CCLexow/Getting_started_with_ROS/README.md

# Getting_started_with_ROS
Repository containing project(s) to learn programming with ROS
