CCLexow/Getting_started_with_ROS/Sharp_DistanceSensor/README.md

Design files (HW/SW/MECH) for a motorized distance sensor to perform 360° scans.

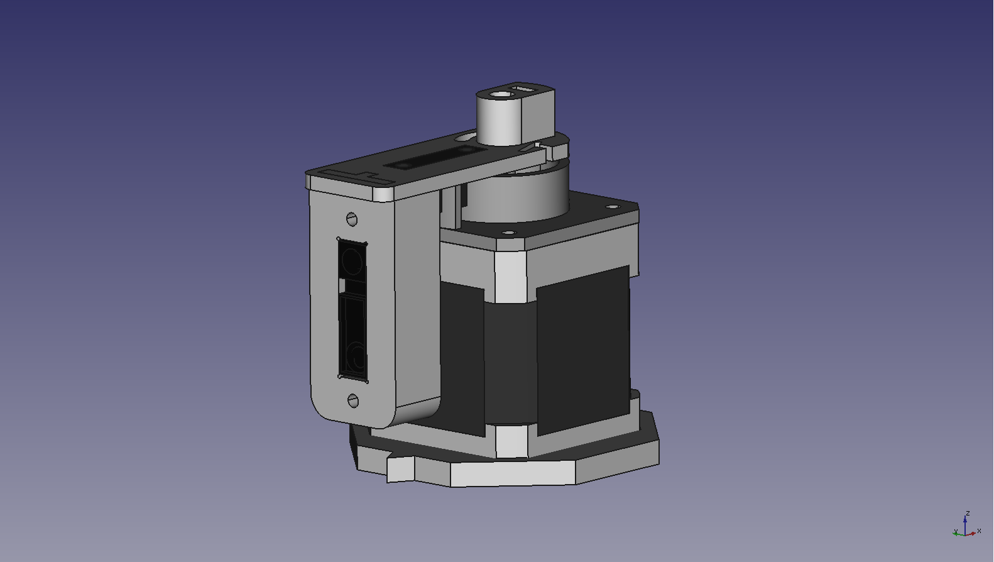
[picture p1: Sharp_DistanceSensor/MCAD/Images/SharpDistanceSensorAssembly.png]


Designed using:
* [FreeCAD](https://www.freecadweb.org)
* [KiCad EDA](http://kicad-pcb.org)
* [System Workbench for STM32](http://www.openstm32.org/HomePage)
