CCLexow/Getting_started_with_ROS/Sharp_DistanceSensor/MCAD/README.md

# MCAD Files



Designed with [FreeCAD](https://www.freecadweb.org)
# Credits
External 3D models:
* [TMC2100 SilentStepStick PCB](https://grabcad.com/library/tmc21x0-silentstepstick-board-1)
* [STM32 "BluePill" module](https://grabcad.com/library/stm32f103c8t6-blue-pill-board-1)
* [Sharp Distance Sensor](https://grabcad.com/library/sharp-gp2y0a21yk0f)
* [NEMA 17 Stepper model](https://github.com/FreeCAD/FreeCAD-library/blob/master/Electrical%20Parts/Motors/NEMA-17_Stepper_Motor_47mm.step)
