CCLexow/Getting_started_with_ROS/Sharp_DistanceSensor/ECAD/README.md

# ECAD Files

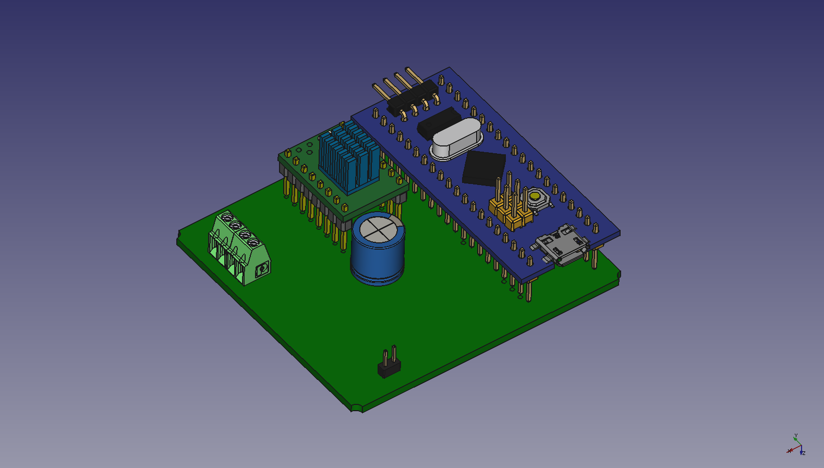
[picture p2: Sharp_DistanceSensor/MCAD/Images/MCU_StepperDriverPCB_Top.png]


Designed with [KiCad EDA](http://kicad-pcb.org)
# Credits
External 3D models:
* [TMC2100 SilentStepStick PCB](https://grabcad.com/library/tmc21x0-silentstepstick-board-1)
* [STM32 "BluePill" module](https://grabcad.com/library/stm32f103c8t6-blue-pill-board-1)
