CCLexow/Getting_started_with_ROS/Sharp_DistanceSensor/ECAD/MCU_StepperDriverPCB/Images/MCU_STMD_PCB_Milled.jpg

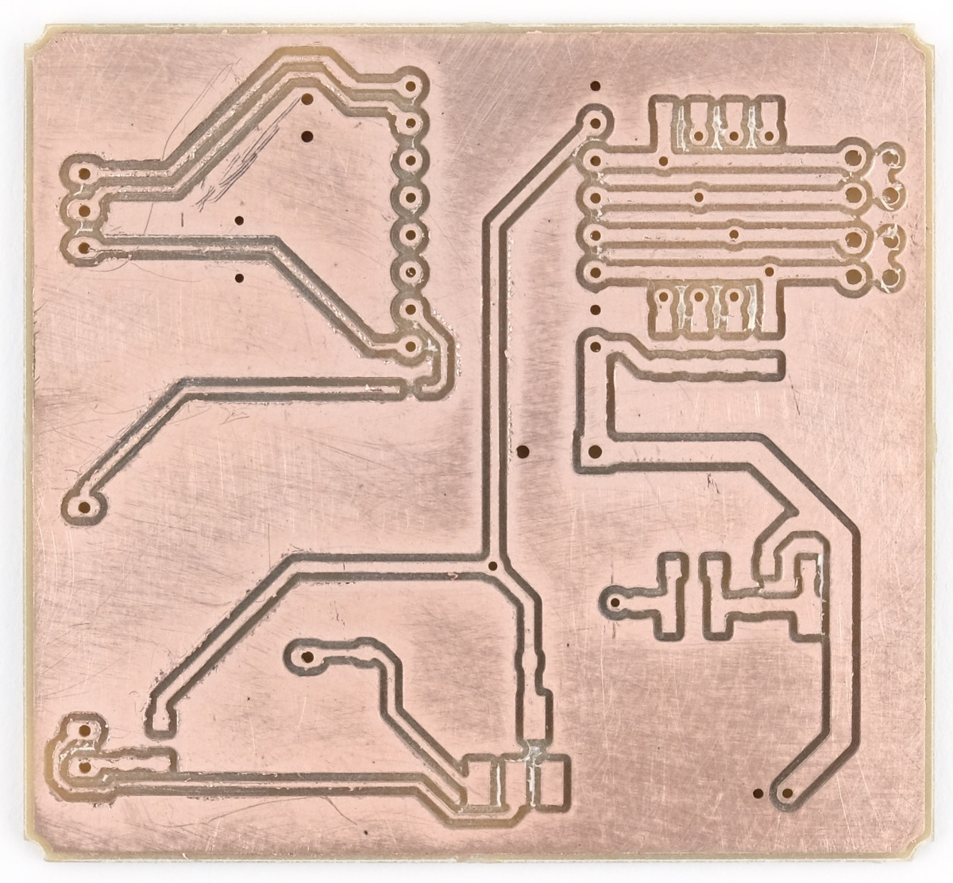
Sharp_DistanceSensor/ECAD/MCU_StepperDriverPCB/Images/MCU_STMD_PCB_Milled.jpg
