CCLexow/Getting_started_with_ROS/Sharp_DistanceSensor/MCAD/Images/MCU_StepperDriverPCB_Bottom.png

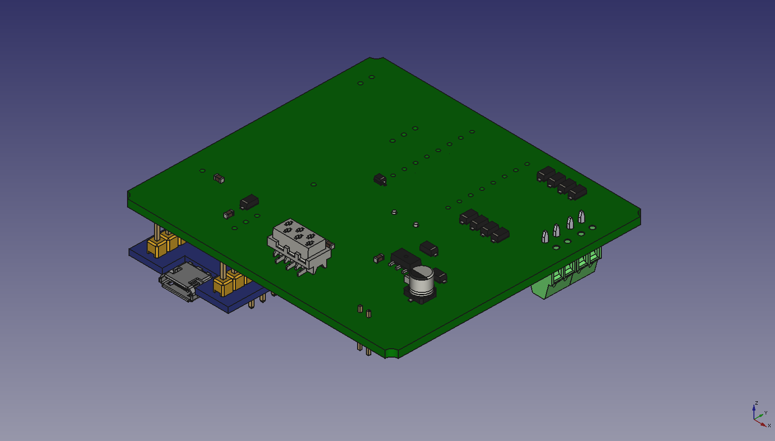
Sharp_DistanceSensor/MCAD/Images/MCU_StepperDriverPCB_Bottom.png
