CCLexow/Getting_started_with_ROS/Sharp_DistanceSensor/MCAD/Assembly_SharpDistanceSensor.FCStd

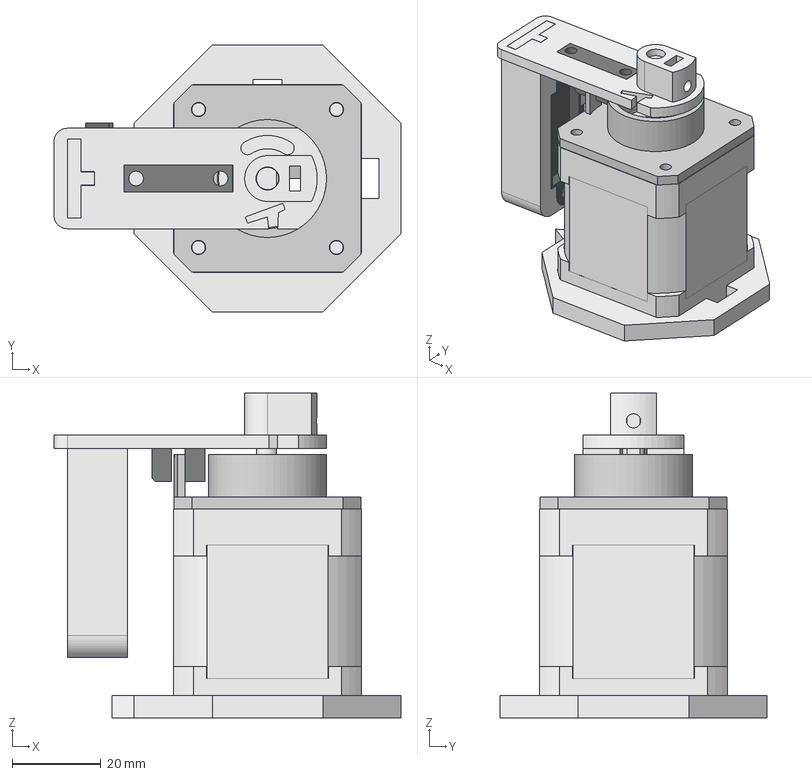
[picture p5: CAD file, 2018-10-25]
Sharp_DistanceSensor/MCAD/Assembly_SharpDistanceSensor.FCStd
78.0 x 60.0 x 73.0 mm
NEMA_17_Stepper_Motor_47mm_step1_01
Orientation_pointer_01
Cable_guide_and_light_barrier_01
Sensor_support_beam_01
ELITR8102_01
Fixture_Distance_Sensor_01
Sharp_GP2Y0A21YK0F_01
