CCLexow/Getting_started_with_ROS/Sharp_DistanceSensor/MCAD/Assembly_PCB_and_StandOffs.FCStd

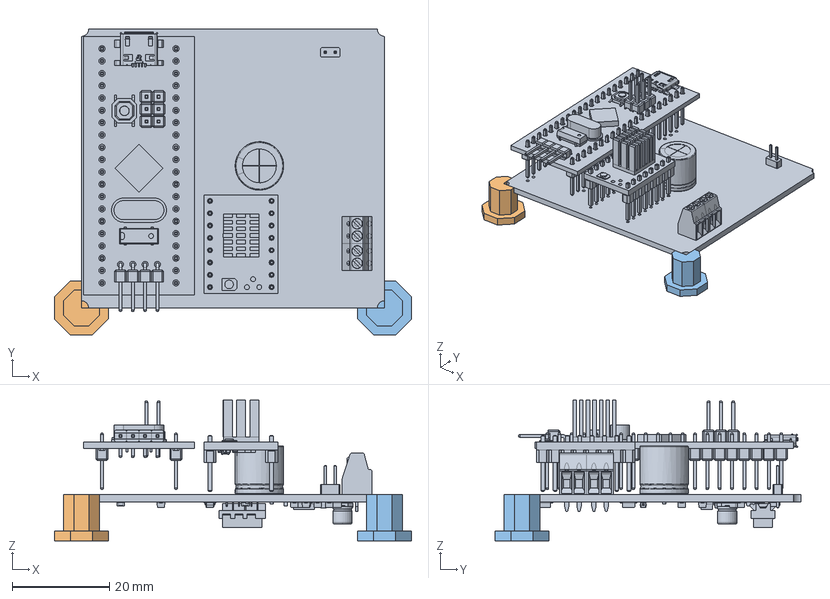
[picture p6: CAD file, 2018-10-25]
Sharp_DistanceSensor/MCAD/Assembly_PCB_and_StandOffs.FCStd
73.6 x 63.0 x 29.0 mm
MCU_StepperDriverPCB_01
PCB_StandOffs_01
PCB_StandOffs_02
