CCLexow/Getting_started_with_ROS/Sharp_DistanceSensor/MCAD/Sensor support beam.FCStd

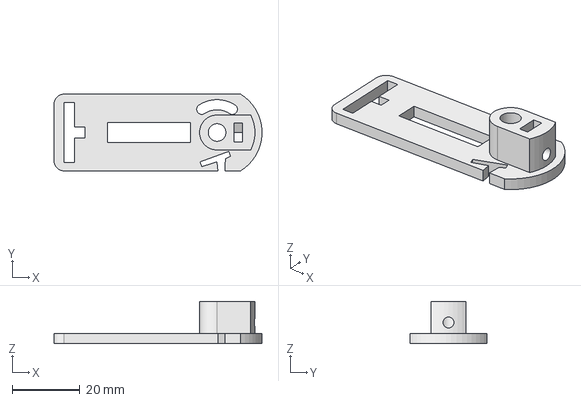
[picture p7: CAD file, 2018-10-25]
Sharp_DistanceSensor/MCAD/Sensor support beam.FCStd
61.2 x 22.6 x 12.5 mm
