CCLexow/Getting_started_with_ROS/Sharp_DistanceSensor/MCAD/Sharp_GP2Y0A21YK0F.FCStd

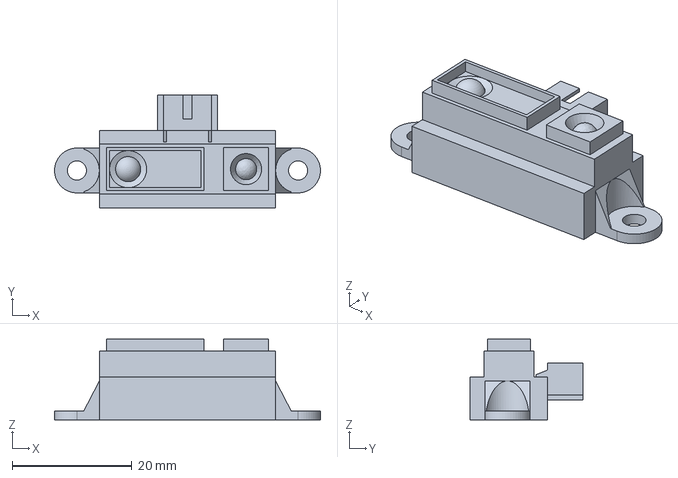
[picture p8: CAD file, 2018-10-25]
Sharp_DistanceSensor/MCAD/Sharp_GP2Y0A21YK0F.FCStd
44.5 x 18.9 x 13.5 mm
