CCLexow/Getting_started_with_ROS/Sharp_DistanceSensor/MCAD/ELITR8102.FCStd

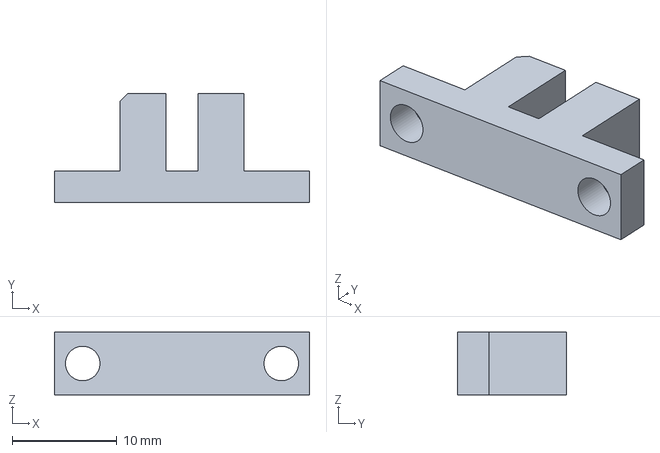
[picture p9: CAD file, 2018-10-25]
Sharp_DistanceSensor/MCAD/ELITR8102.FCStd
24.4 x 10.4 x 6.00 mm
