CCLexow/Getting_started_with_ROS/Sharp_DistanceSensor/MCAD/MCU_StepperDriverPCB.FCStd

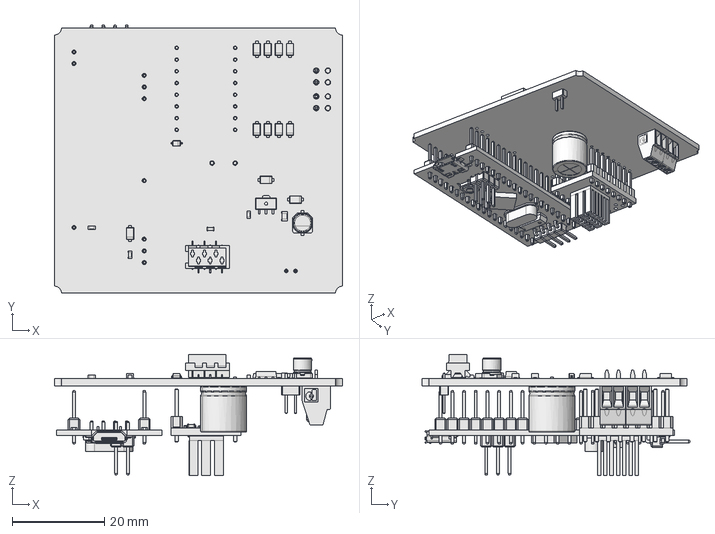
[picture p10: CAD file, 2018-10-25]
Sharp_DistanceSensor/MCAD/MCU_StepperDriverPCB.FCStd
62.5 x 58.2 x 26.3 mm
