CCLexow/Getting_started_with_ROS/Sharp_DistanceSensor/MCAD/PCB_StandOffs.FCStd

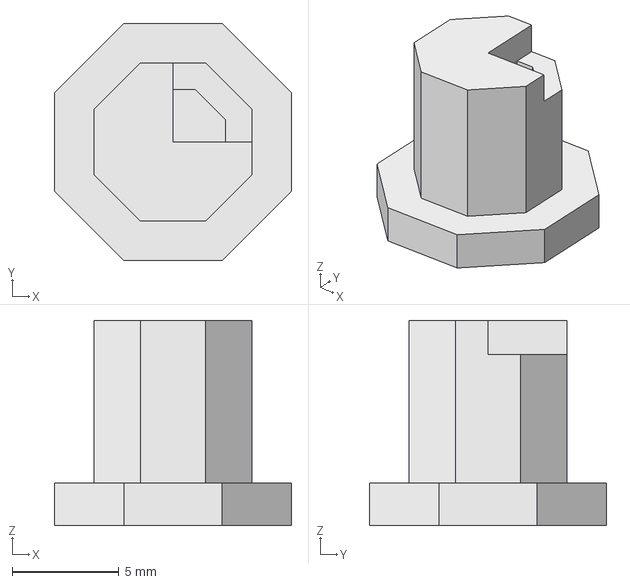
[picture p11: CAD file, 2018-10-25]
Sharp_DistanceSensor/MCAD/PCB_StandOffs.FCStd
11.1 x 11.1 x 9.60 mm
