CCLexow/Getting_started_with_ROS/Sharp_DistanceSensor/MCAD/NEMA-17_Stepper_Motor_47mm.step

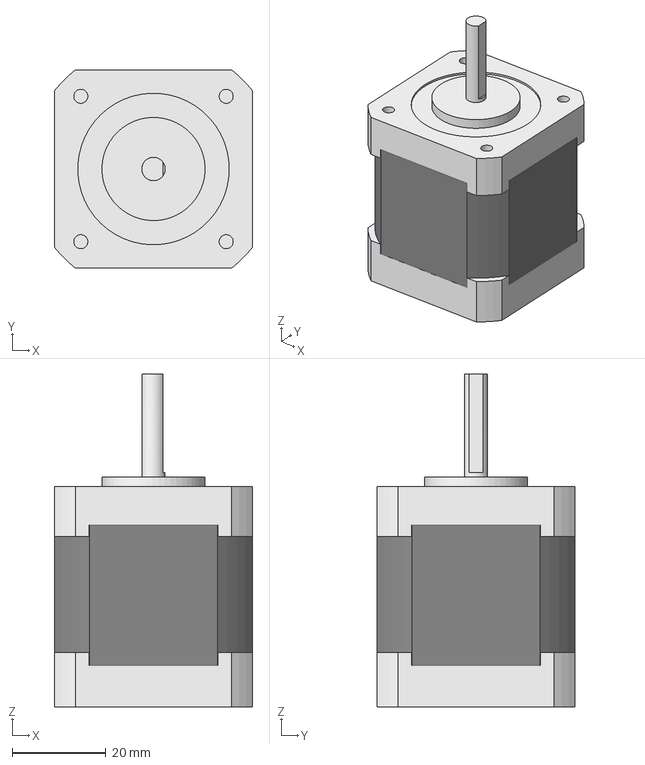
[picture p12: CAD file, 2018-10-25]
Sharp_DistanceSensor/MCAD/NEMA-17_Stepper_Motor_47mm.step
42.3 x 42.3 x 71.0 mm
