CCLexow/Getting_started_with_ROS/Sharp_DistanceSensor/MCAD/Orientation pointer.FCStd

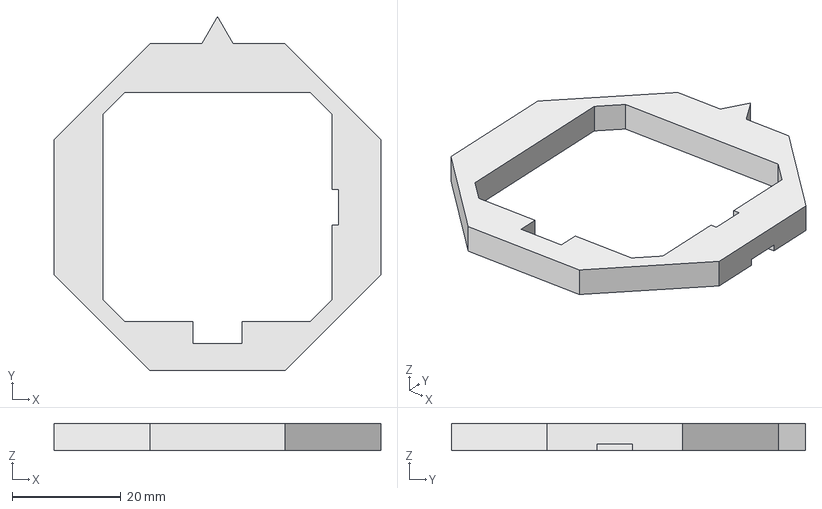
[picture p13: CAD file, 2018-10-10]
Sharp_DistanceSensor/MCAD/Orientation pointer.FCStd
60.0 x 65.0 x 5.00 mm
