CCLexow/Getting_started_with_ROS/Sharp_DistanceSensor/MCAD/Fixture Distance Sensor.FCStd

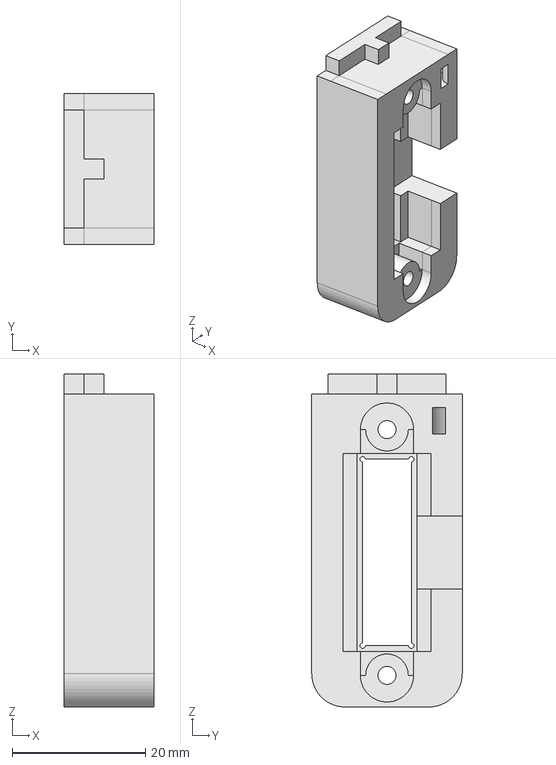
[picture p14: CAD file, 2018-10-08]
Sharp_DistanceSensor/MCAD/Fixture Distance Sensor.FCStd
13.5 x 22.6 x 50.0 mm
