CCLexow/Getting_started_with_ROS/Sharp_DistanceSensor/MCAD/Cable guide and light barrier.FCStd

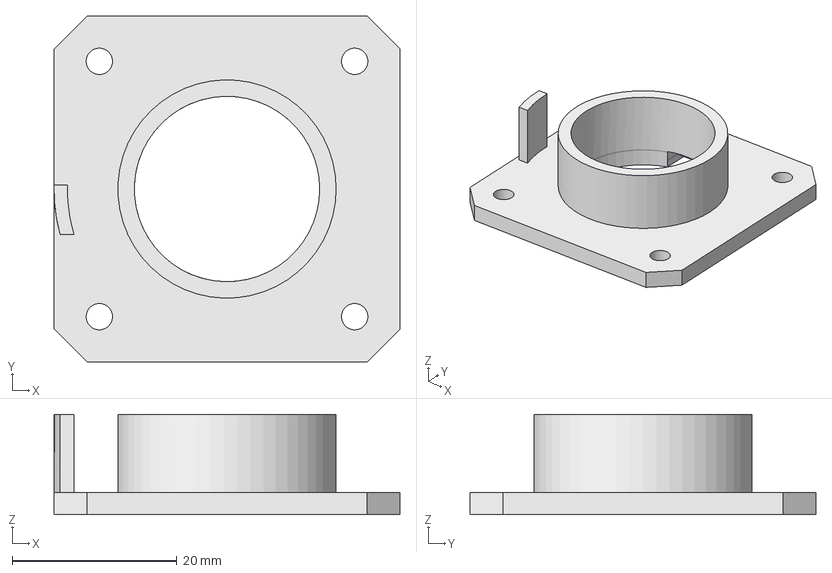
[picture p15: CAD file, 2018-10-08]
Sharp_DistanceSensor/MCAD/Cable guide and light barrier.FCStd
42.0 x 42.0 x 12.2 mm
