CCLexow/Getting_started_with_ROS/Sharp_DistanceSensor/MCAD/Images/SharpDistanceSensorAssembly_with_Annotations.png

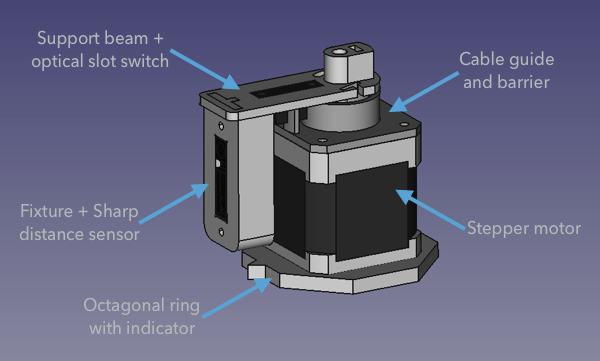
Sharp_DistanceSensor/MCAD/Images/SharpDistanceSensorAssembly_with_Annotations.png
