CCLexow/Getting_started_with_ROS/Sharp_DistanceSensor/ECAD/MCU_StepperDriverPCB/MCU_StepperDriverPCB.kicad_pcb

## KiCad design Sharp_DistanceSensor/ECAD/MCU_StepperDriverPCB/MCU_StepperDriverPCB.kicad_pcb (2018-10-25)

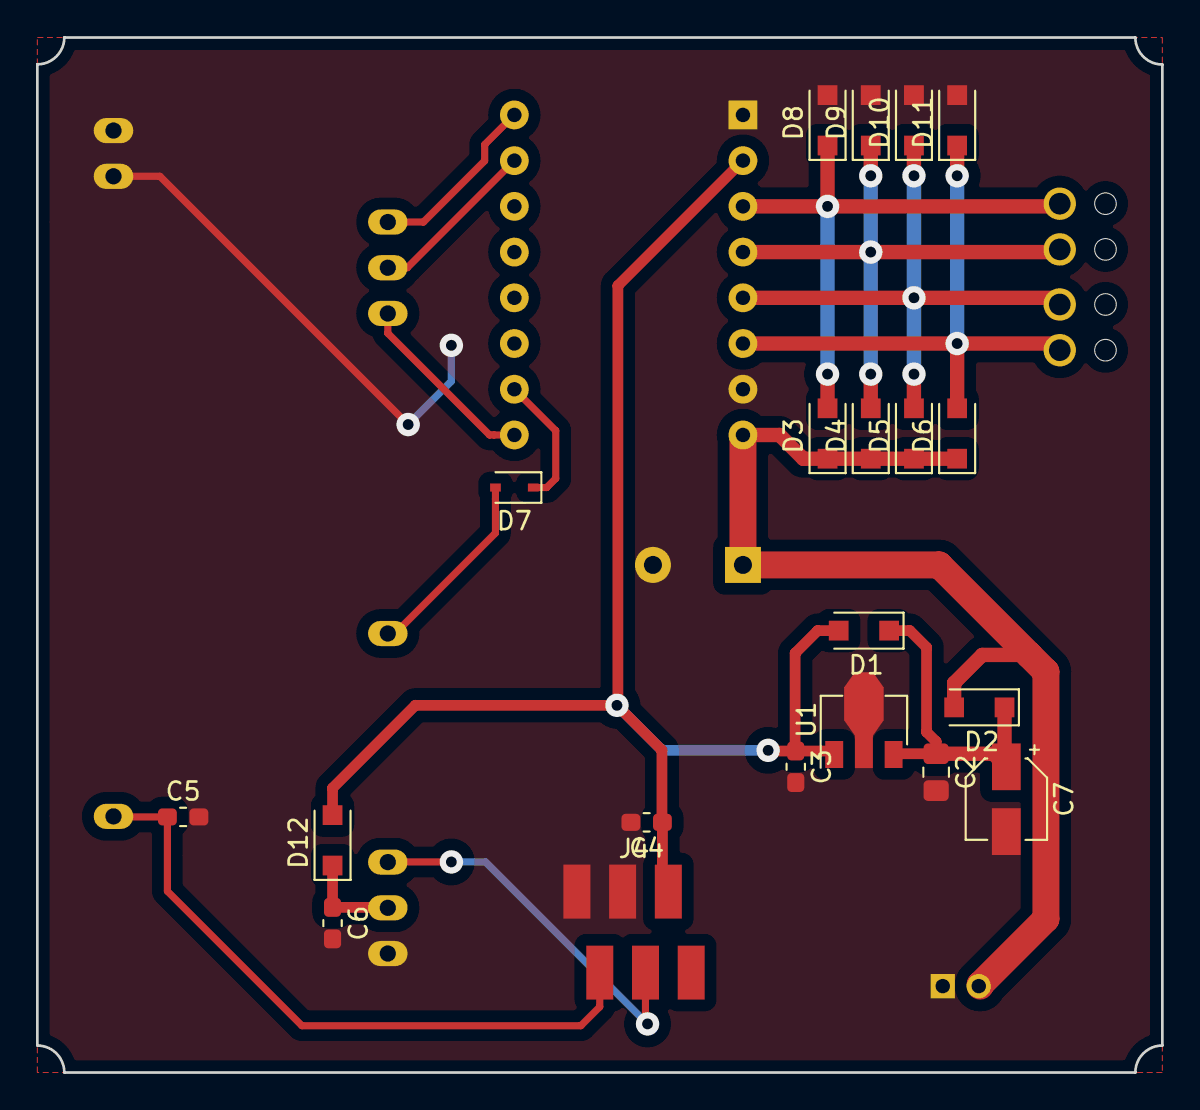
[picture p17: board MCU_StepperDriverPCB.kicad_pcb from above]

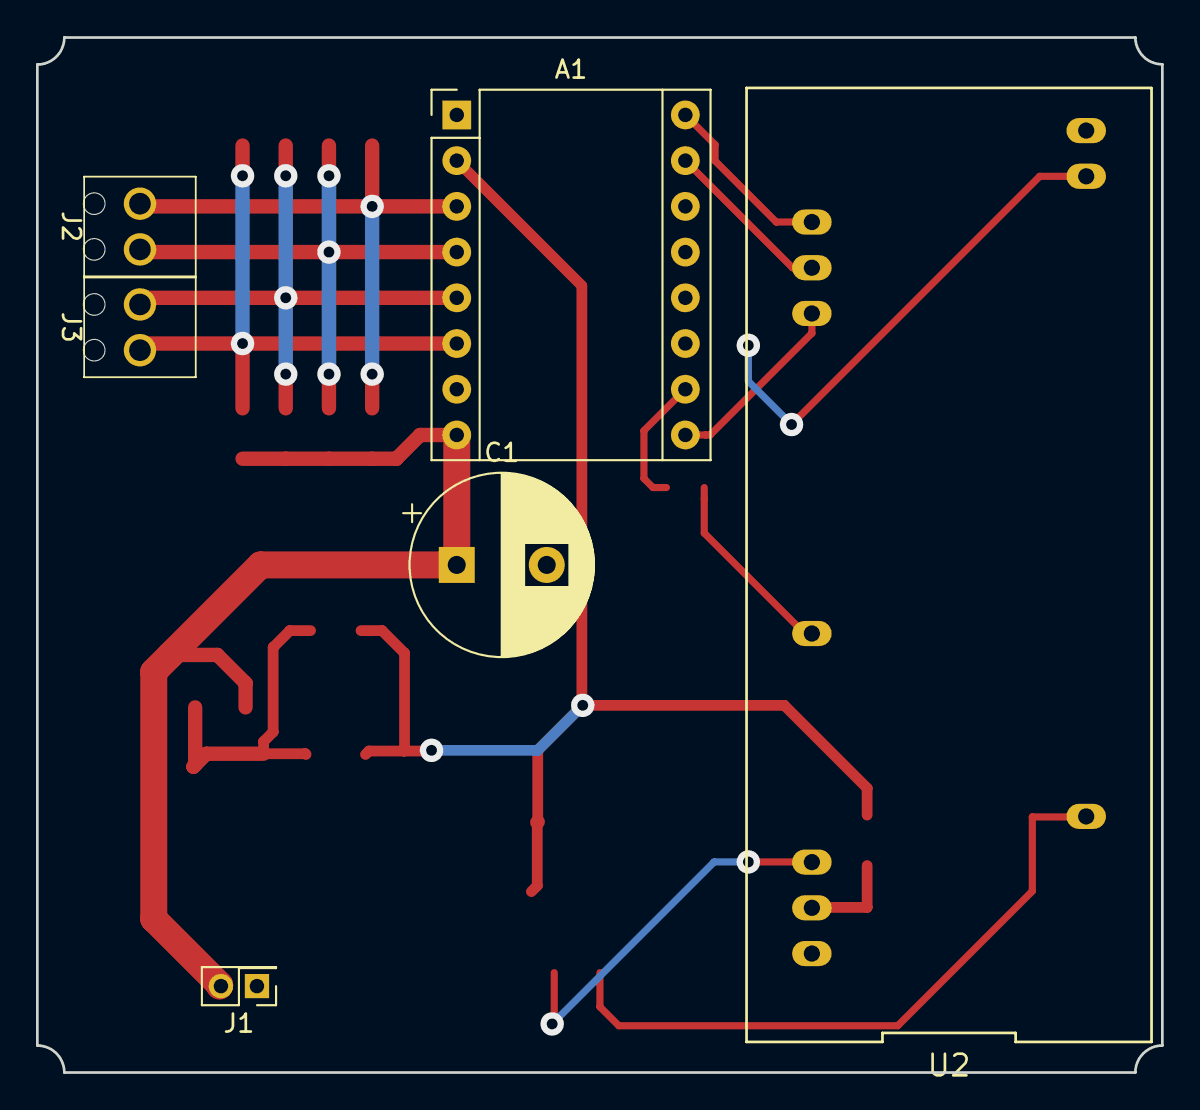
[picture p18: board MCU_StepperDriverPCB.kicad_pcb from below]

Board: 2 copper layers, 62.5 x 57.5 mm, 26 parts (6 on the bottom side), 16 nets.

Parts:
A1: Watterott SilentStepStick TMC2100; Pololu_Breakout-16_15.2x20.3mm
C1: 470u/25V; CP_Radial_D10.0mm_P5.00mm
C2: 1u; C_0805_2012Metric_Pad1.15x1.40mm_HandSolder
C3, C4, C5, C6: 100n; C_0603_1608Metric_Pad1.05x0.95mm_HandSolder
C7: 4u7/35V; CP_Elec_4x4.5
D1, D2, D3, D4, D5, D6, D8, D9, D10, D11, D12: NRVTS260ESFT1G; D_SOD-123F
D7: 1N4148WS; D_SOD-323
J1: Conn_01x02; PinHeader_2x01_P2.00mm_Vertical
J2, J3: Conn_01x02_Female; MPT_0,5_02_2,54
J4: Conn_01x05_Female; MM-FL-6S
U1: TA78L05F; SOT-89-3_millable_0.6mm
U2: STM32_BluePill_PortView; STM32_BluePill_ROS_GS

Connections:
+5V: A1.2, C3.1, C4.1, D1.2, D12.2, J4.5, U1.1
+12V: A1.8, C1.1, D2.2, D3.1, D4.1, D5.1, D6.1, J1.2
/AN_Distance: C5.1, J4.2, U2.5
/Light_Barrier: J4.4, U2.37
/STMD_Dir: A1.16, U2.23
/STMD_En: A1.9, U2.25
/STMD_Step: A1.15, U2.24
GND: A1.1, A1.7, C1.2, C2.2, C3.2, C4.2, C5.2, C6.2, C7.2, D8.2, D9.2, D10.2, D11.2, J1.1, J4.1, J4.3, U1.2, U2.19, U2.20, U2.39
unnamed: A1.3, D3.2, D8.1, J2.2
unnamed: A1.4, D4.2, D9.1, J2.1
unnamed: A1.5, D5.2, D10.1, J3.2
unnamed: A1.6, D6.2, D11.1, J3.1
unnamed: A1.10, D7.1
unnamed: C2.1, C7.1, D1.1, D2.1, U1.3
unnamed: C6.1, D12.1, U2.38
unnamed: D7.2, U2.32
