CCLexow/Getting_started_with_ROS/Sharp_DistanceSensor/SW/BluePill_SharpSensor_ROS/BluePill_SharpSensor_ROS.ioc

Mcu.UserName=STM32F103C8Tx
PA0-WKUP.GPIO_Label=AN_Distance
PA0-WKUP.Signal=ADCx_IN0
PA11.Signal=USB_DM
PA12.Signal=USB_DP
PA13.Signal=SYS_JTMS-SWDIO
PA14.Signal=SYS_JTCK-SWCLK
PA8.GPIO_Label=STMD_En
PA8.Signal=GPIO_Output
PB14.GPIO_Label=STMD_Dir
PB14.Signal=GPIO_Output
PB15.GPIO_Label=STMD_Step
PB15.Signal=GPIO_Output
PB4.GPIO_Label=STMD_Cfg1
PB4.Signal=GPIO_Output
PB9.GPIO_Label=IN_LightBarrier
PB9.Signal=GPIO_Input
PC13-TAMPER-RTC.GPIO_Label=SYS_LED
PC13-TAMPER-RTC.Signal=GPIO_Output
PC14-OSC32_IN.Signal=RCC_OSC32_IN
PC15-OSC32_OUT.Signal=RCC_OSC32_OUT
PD0-OSC_IN.Signal=RCC_OSC_IN
PD1-OSC_OUT.Signal=RCC_OSC_OUT
