CCLexow/Getting_started_with_ROS/Sharp_DistanceSensor/SW/BluePill_SharpSensor_ROS/Src/ledStatus.cpp

/*
 * ledStatus.cpp
 *
 *  Created on: Sep 23, 2018
 *      Author: Itama
 */

#include "stm32f1xx_hal.h"
#include "nbt.h"

static nbt_t lednbt;

extern "C" void init_ledStatus()
{
	NBT_init(&lednbt, 500);
}

extern "C" void ledStatus_handler()
{
	if (NBT_handler(&lednbt))
	{
	  HAL_GPIO_TogglePin(SYS_LED_GPIO_Port, SYS_LED_Pin);
	}
}
