CCLexow/Getting_started_with_ROS/(commit log)

2018-10-08 Commit of MCAD files for the Sharp GP2Y0A21YK0F distance sensor
    [Cable guide and light barrier.FCStd, Fixture Distance Sensor.FCStd, Sensor support beam.FCStd]
2018-10-09 Added KiCad project for a PCB that interfaces the MCU with the sensors
    [SensorConnectionPCB.kicad_pcb, SensorConnectionPCB.sch]
2018-10-10 Updated the mechanical construction. Added a SW project to read the two sensors using an STM32 MCU
    [New_configuration.cfg, Orientation pointer.FCStd]
2018-10-10 Software now capable to sample the distance sensor on demand. Implemented serial command interfae to control sensor sampling.
2018-10-11 Added KiCad project for a PCB containing the MCU and the stepper motor driver for the Sharp distance sensor on stepper motor assembly
    [MCU_StepperDriverPCB.kicad_pcb, MCU_StepperDriverPCB.sch]
2018-10-25 MCAD: Added missing parts of sensor assembly. ECAD: updated PCB for MCU and stepper motor driver. SW: Implemented functionality to perform 360deg scans.
    [Assembly_PCB_and_StandOffs.FCStd, Assembly_SharpDistanceSensor.FCStd, ELITR8102.FCStd, MCU_StepperDriverPCB.FCStd, MCU_StepperDriverPCB.kicad_pcb, MCU_StepperDriverPCB.sch, NEMA-17_Stepper_Motor_47mm.step, PCB_StandOffs.FCStd]
2018-11-19 SW: Changed sensor sampling from task based to DMA. Implemented homing cycle. Optimized stepper motor driving.
2018-11-20 SW: Implemented IR distance scan with ROS. Scanning controlled via message published by PC. Scann result transmitted in LaserScan message for 10 scans per message.
2018-11-21 SW: IR scanning is now completly controllable via ROS (homing, continuous scanning, stopping, etc.)
2018-11-28 SW: Corrected angle increment to reflect the coordinate system convention
    [main.c]
